MoeclubM/AntDec-O1/Mechanical/SolidWorks/AntDec_O1_Exploded.SLDASM

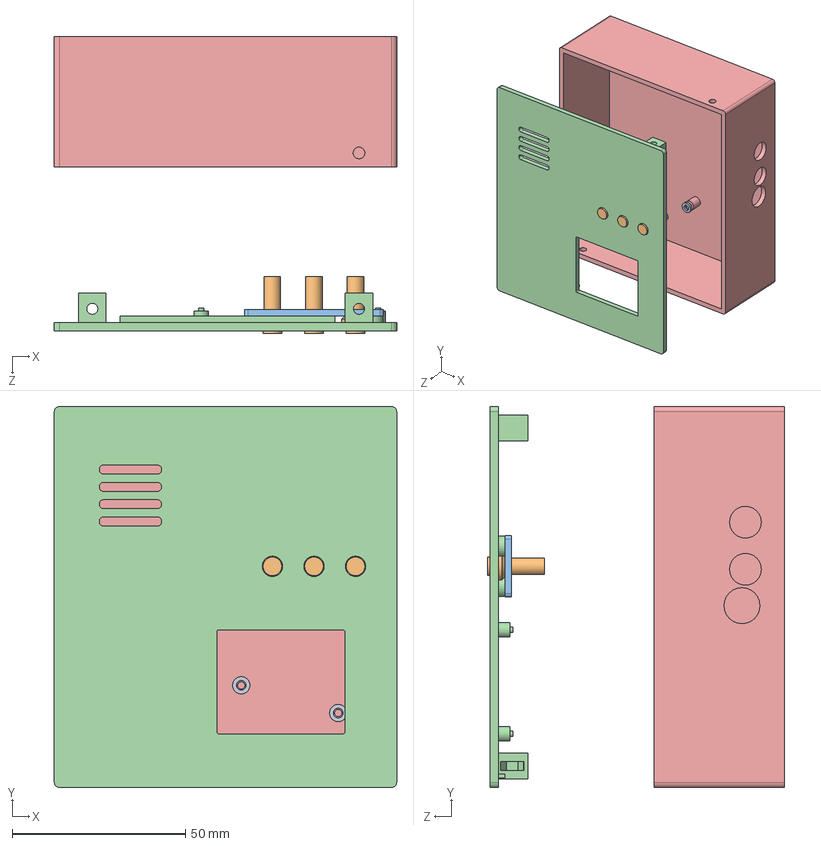
[picture p1: CAD file, 2026-11-12]
Mechanical/SolidWorks/AntDec_O1_Exploded.SLDASM
98.9 x 110.0 x 85.7 mm
AntDec_O1_Base
AntDec_O1_Lid
AntDec_O1_Button_Retainer
AntDec_O1_Button x 3
AntDec_O1_1mm_Shim x 6
