MoeclubM/AntDec-O1/Mechanical/SolidWorks/AntDec_O1_Button.SLDPRT

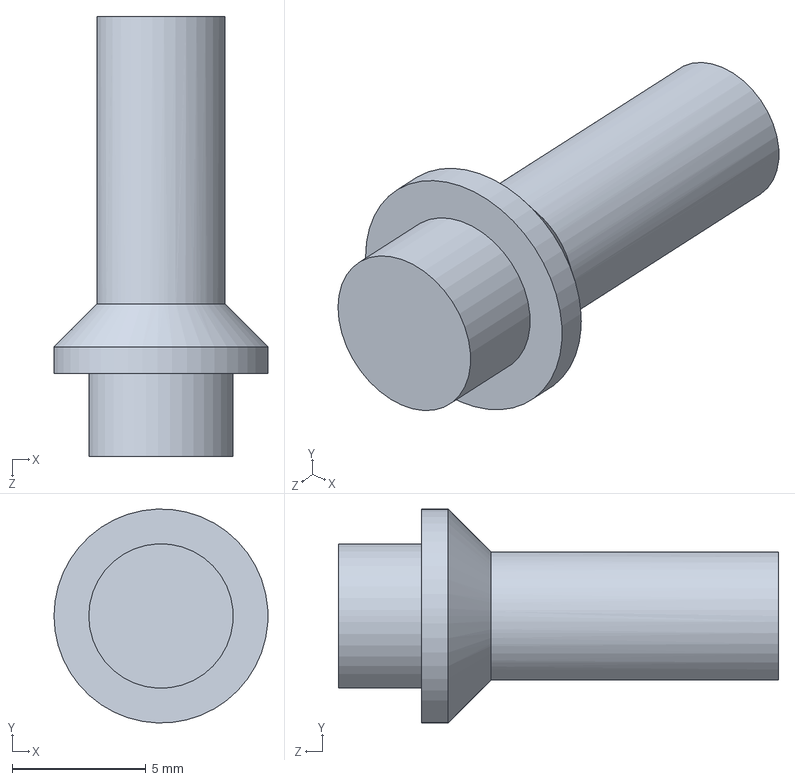
[picture p3: CAD file, 2026-11-12]
Mechanical/SolidWorks/AntDec_O1_Button.SLDPRT
8.00 x 8.00 x 16.4 mm
