MoeclubM/AntDec-O1/Mechanical/SolidWorks/AntDec_O1_1mm_Shim.SLDPRT

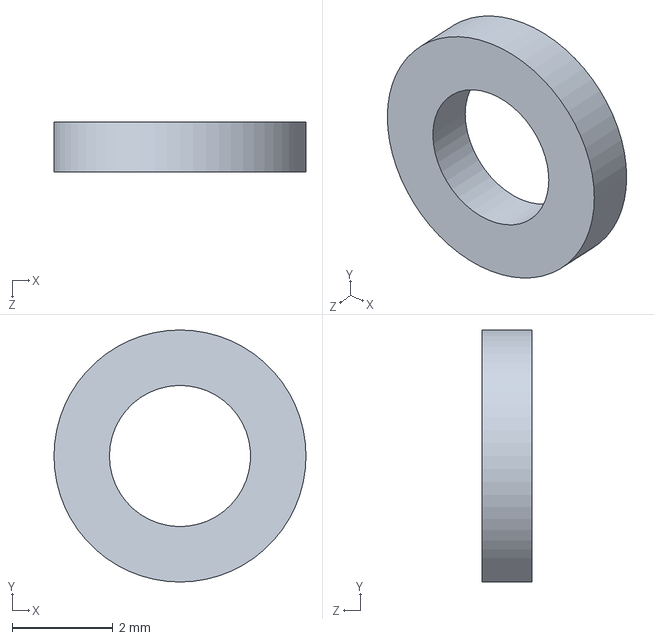
[picture p4: CAD file, 2026-11-12]
Mechanical/SolidWorks/AntDec_O1_1mm_Shim.SLDPRT
5.00 x 5.00 x 1.00 mm
