MoeclubM/AntDec-O1/Mechanical/SolidWorks/AntDec_O1_Lid.SLDPRT

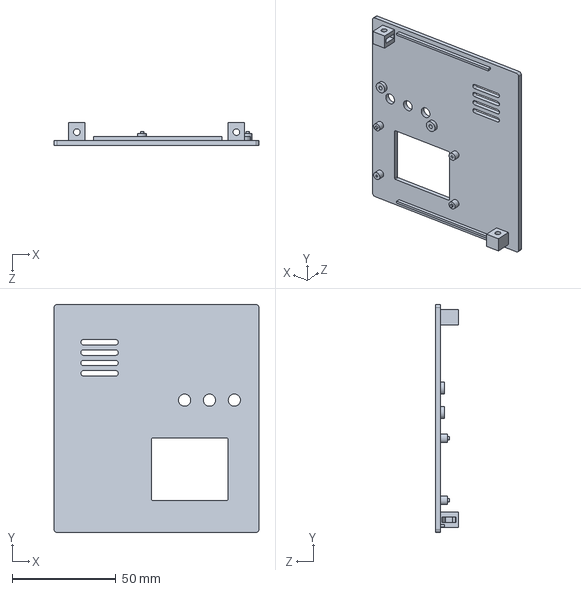
[picture p5: CAD file, 2026-11-12]
Mechanical/SolidWorks/AntDec_O1_Lid.SLDPRT
98.9 x 110.0 x 11.0 mm
