MoeclubM/AntDec-O1/Mechanical/SolidWorks/AntDec_O1_Base.SLDPRT

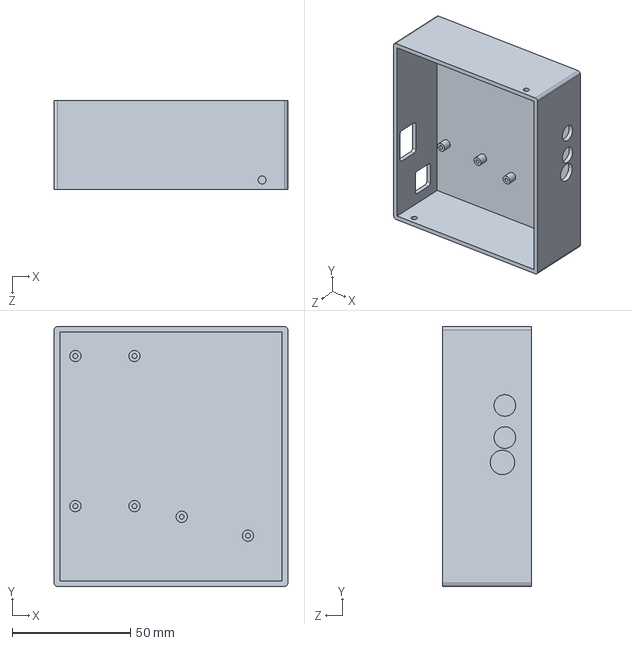
[picture p6: CAD file, 2026-11-12]
Mechanical/SolidWorks/AntDec_O1_Base.SLDPRT
98.9 x 110.0 x 37.6 mm
