MoeclubM/AntDec-O1/Mechanical/SolidWorks/AntDec_O1_Button_Retainer.SLDPRT

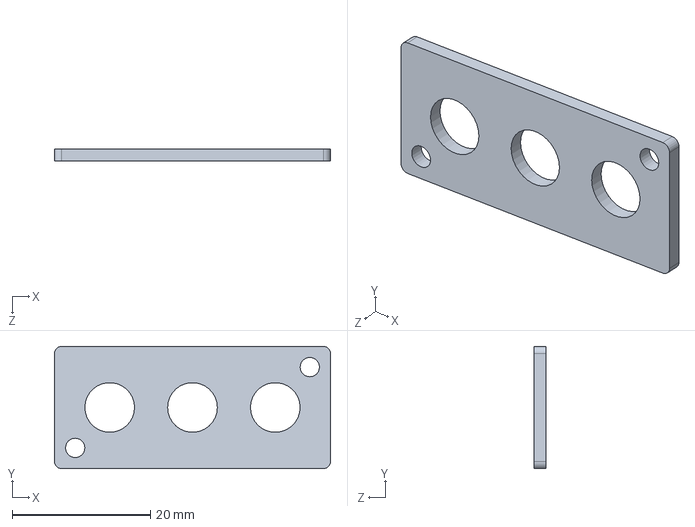
[picture p7: CAD file, 2026-11-12]
Mechanical/SolidWorks/AntDec_O1_Button_Retainer.SLDPRT
40.0 x 17.7 x 1.80 mm
