MoeclubM/AntDec-O1/(list of files, cad)

Other CAD files:
Mechanical/Print/AntDec_O1_1mm_Shim.stl
Mechanical/Print/AntDec_O1_Base.stl
Mechanical/Print/AntDec_O1_Button.stl
Mechanical/Print/AntDec_O1_Button_Retainer.stl
Mechanical/Print/AntDec_O1_Lid.stl
