MoeclubM/AntDec-O1/STM32/AntDec-O1/Core/Src/main.c

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
/* Includes ------------------------------------------------------------------*/
#include "main.h"
#include "adc.h"
#include "dma.h"
#include "i2c.h"
#include "spi.h"
#include "tim.h"
#include "usb_device.h"
#include "gpio.h"

/* USER CODE BEGIN Includes */
#include "board_hw.h"
#include "power_seq.h"
#include "st7789.h"
#include "ui.h"
#include "xmos_link.h"
#include "usb_debug.h"
/* USER CODE END Includes */


void SystemClock_Config(void);
/**
  * @brief  The application entry point.
  * @retval int
  */
int main(void)
{

  /* MCU Configuration--------------------------------------------------------*/

  /* Reset of all peripherals, Initializes the Flash interface and the Systick. */
  HAL_Init();

  /* Configure the system clock */
  SystemClock_Config();

  /* Initialize all configured peripherals */
  MX_GPIO_Init();
  MX_DMA_Init();
  MX_SPI1_Init();
  MX_ADC1_Init();
  MX_I2C1_Init();
  MX_TIM2_Init();
  MX_USB_DEVICE_Init();
  /* USER CODE BEGIN 2 */
  (void)HAL_TIM_Base_Start(&htim2);
  SET_BIT(ADC1->CR2, ADC_CR2_TSVREFE);
  (void)HAL_ADCEx_Calibration_Start(&hadc1);
  ST7789_Init(true);
  PowerSeq_Init();
  XmosLink_Init();
  UI_Init();
  /* USER CODE END 2 */

  /* Infinite loop */
  /* USER CODE BEGIN WHILE */
  while (1)
  {
    uint32_t now_ms = HAL_GetTick();
    PowerSeq_Tick(now_ms);
    XmosLink_Tick(now_ms);
    UsbDebug_Tick(now_ms);
    UI_Tick(now_ms);
    /* USER CODE END WHILE */

    /* USER CODE BEGIN 3 */
  }
  /* USER CODE END 3 */
}

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
