MoeclubM/AntDec-O1/STM32/AntDec-O1/AntDec-O1.ioc

Mcu.UserName=STM32F105RCTx
PA0-WKUP.Signal=ADCx_IN0
PA1.Signal=ADCx_IN1
PA11.Signal=USB_OTG_FS_DM
PA12.Signal=USB_OTG_FS_DP
PA13.Signal=SYS_JTMS-SWDIO
PA14.Signal=SYS_JTCK-SWCLK
PA2.Signal=GPIO_Output
PA3.Signal=GPIO_Output
PA4.Signal=GPIO_Output
PA5.Signal=SPI1_SCK
PA7.Signal=SPI1_MOSI
PA9.Signal=GPIO_Input
PB0.Signal=GPIO_Output
PB1.Signal=GPIO_Input
PB6.Signal=I2C1_SCL
PB7.Signal=I2C1_SDA
PC0.Signal=GPIO_Output
PC1.Signal=GPIO_Output
PC13-TAMPER-RTC.Signal=GPIO_Input
PC14-OSC32_IN.Signal=GPIO_Input
PC15-OSC32_OUT.Signal=GPIO_Input
PC2.Signal=GPIO_Output
PC3.Signal=GPIO_Output
PC4.Signal=GPIO_Output
PC5.Signal=GPIO_Output
PC6.Signal=GPXTI6
PC7.Signal=GPIO_Input
PC9.Signal=GPIO_Input
PD0-OSC_IN.Signal=RCC_OSC_IN
PD1-OSC_OUT.Signal=RCC_OSC_OUT
