MoeclubM/AntDec-O1/XMOS/app_antdec_o1/src/clock_monitor.h

#ifndef CLOCK_MONITOR_H_
#define CLOCK_MONITOR_H_

#include <xccompat.h>

void ClockMonitor_Measure(REFERENCE_PARAM(unsigned, cycles),
                          REFERENCE_PARAM(unsigned, reference_ticks));

#endif
