MoeclubM/AntDec-O1/(notices)

Notices in the files:
STM32/AntDec-O1/Core/Src/main.c:
Copyright (c) 2026 STMicroelectronics.
All rights reserved.
This software is licensed under terms that can be found in the LICENSE file
